rmingon/drone-uwb/base/README.md

## BASE

##### This base use ESP-IDF code for know distance between EACH drone and himself

#### REAL VIEW

REAL VIEW

#### SCHEMATIC VIEW

SCHEMATIC VIEW

#### PCB VIEW

PCB VIEW

#### 3D VIEW

3D VIEW
