rmingon/drone-uwb/drone_2s/README.md

# Drone with 2s battery

### this version use 2s battery for more power in motor with XT30 connector

3d
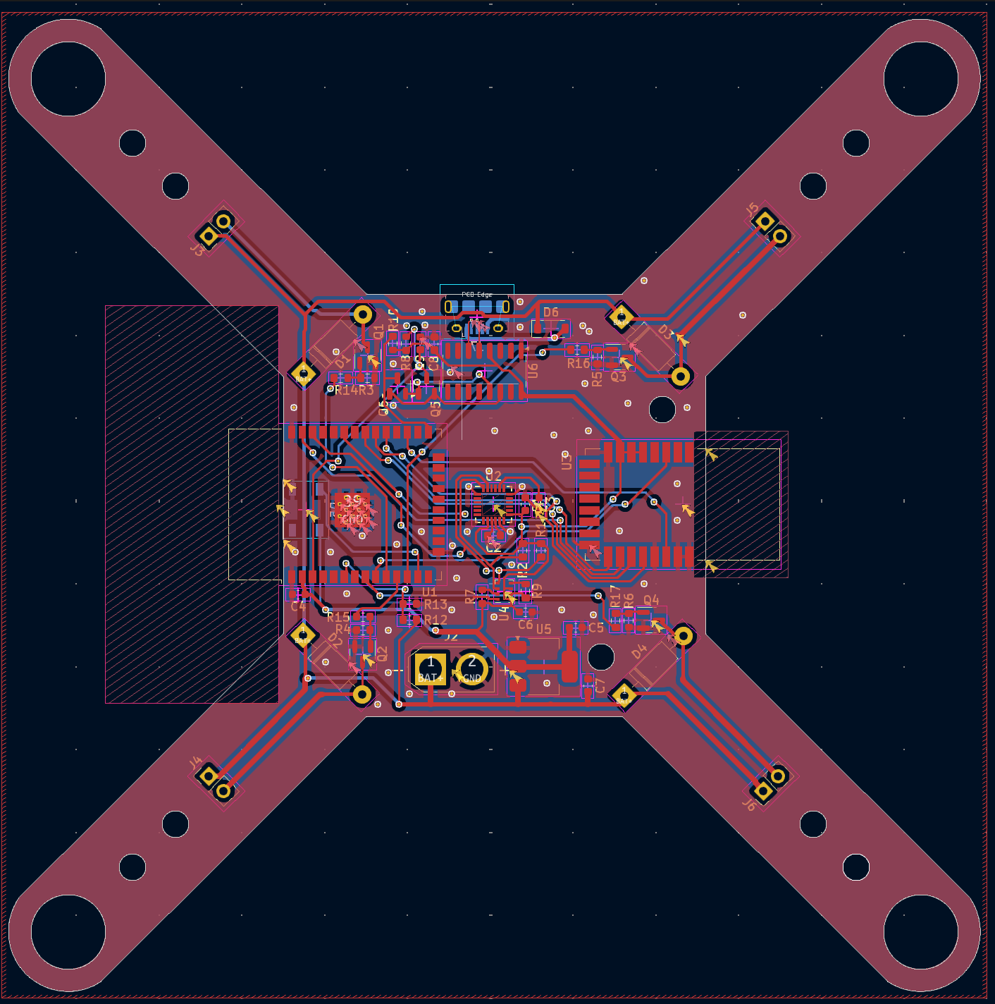
[picture p17: drone_2s/pcb.png]

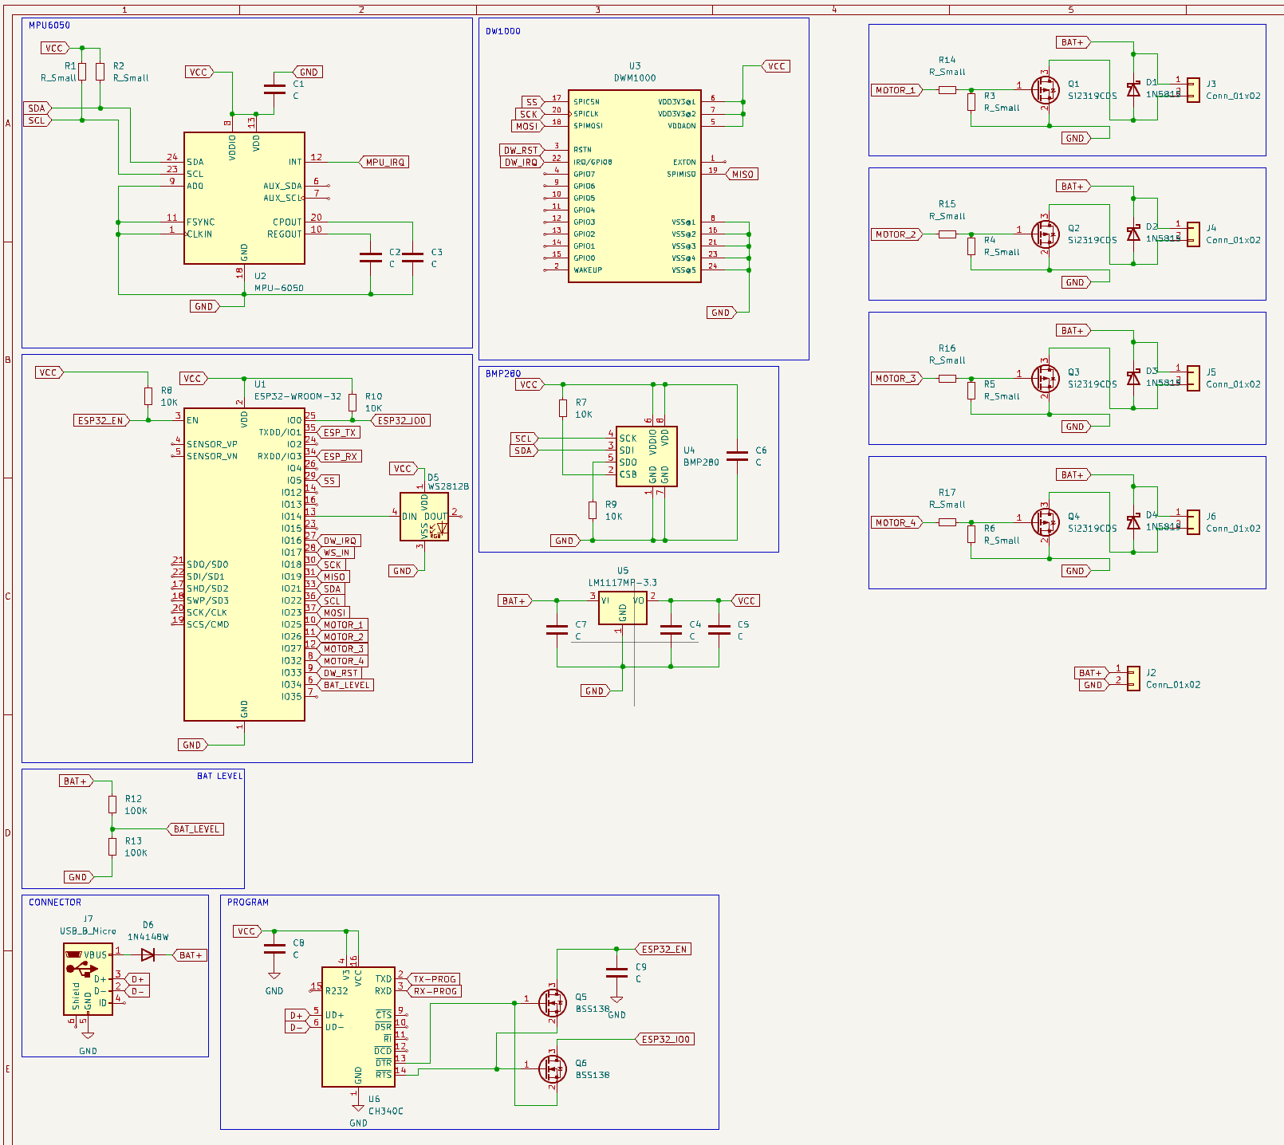
[picture p18: drone_2s/schematic.png]
schematic
