rmingon/drone-uwb/(threads)

Thread 1 (2024-06-29):

Fascinated

jeylites, 2024-06-29:
Hi, seem like a cool project would like to see more development on this. What's the difference between the old and new, beacuse I see the old has a UWB DWM1000 but the new has none but I see two 8 pin header.  How is the localization done for the new, WIFI?

rmingon, 2024-06-29:
Hey @jeylites,
Nice to meet you,
You are right the V2 is an error it's use machine vision and not UWB, I move it to new repository.
The new drone is more like v1.1 than v2, the v1.1 can use external ESC.
The code is the same for v1 and v1.1.
I will shortly add code for bases modules.
