rmingon/drone-uwb/base/code/components/DW1000Ng/include/DW1000NgRTLS.hpp

/*
 * MIT License
 * 
 * Copyright (c) 2018 Michele Biondi, Andrea Salvatori
 * 
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
 * THE SOFTWARE IS PROVIDED "AS IS", WITHOUT WARRANTY OF ANY KIND, EXPRESS OR
 * IMPLIED, INCLUDING BUT NOT LIMITED TO THE WARRANTIES OF MERCHANTABILITY,
 * FITNESS FOR A PARTICULAR PURPOSE AND NONINFRINGEMENT. IN NO EVENT SHALL THE
 * AUTHORS OR COPYRIGHT HOLDERS BE LIABLE FOR ANY CLAIM, DAMAGES OR OTHER
 * LIABILITY, WHETHER IN AN ACTION OF CONTRACT, TORT OR OTHERWISE, ARISING FROM,
 * OUT OF OR IN CONNECTION WITH THE SOFTWARE OR THE USE OR OTHER DEALINGS IN THE
 * SOFTWARE.
*/

#pragma once

#include "DW1000NgPort.hpp"

/* Frame control */
constexpr byte BLINK = 0xC5;
constexpr byte DATA = 0x41;
constexpr byte SHORT_SRC_AND_DEST = 0x88;
constexpr byte LONG_SRC_AND_DEST = 0xCC;
constexpr byte SHORT_SRC_LONG_DEST = 0x8C;
constexpr byte LONG_SRC_SHORT_DEST = 0xC8;

/* Application ID */
constexpr byte RTLS_APP_ID_LOW = 0x9A;
constexpr byte RTLS_APP_ID_HIGH = 0x60;
constexpr uint16_t RTLS_APP_ID = RTLS_APP_ID_LOW | ((uint16_t) (RTLS_APP_ID_HIGH << 8));

/* Function code */
constexpr byte ACTIVITY_CONTROL = 0x10;
constexpr byte RANGING_INITIATION = 0x20;
constexpr byte RANGING_TAG_POLL = 0x21;
constexpr byte RANGING_TAG_FINAL_RESPONSE_EMBEDDED = 0x23;
constexpr byte RANGING_TAG_FINAL_RESPONSE_NO_EMBEDDED = 0x25;
constexpr byte RANGING_TAG_FINAL_SEND_TIME = 0x27;

/* Activity code */
constexpr byte ACTIVITY_FINISHED = 0x00;
constexpr byte RANGING_CONFIRM = 0x01;
constexpr byte RANGING_CONTINUE = 0x02;

/* BLINK Encoding Header */
constexpr byte BATTERY_GOOD = 0x00;
constexpr byte BATTERY_10_30_PERCENT = 0x02;
constexpr byte BATTERY_0_10_PERCENT = 0x01;
constexpr byte NO_BATTERY_STATUS = 0x03;

constexpr byte TEMPERATURE_DATA = 0x20;

constexpr byte EX_ID = 0x80;
constexpr byte NO_EX_ID = 0x40;

/* BLINK Ext Header */
constexpr byte BLINK_RATE_AND_LISTENING = 0x01;
constexpr byte TAG_LISTENING_NOW = 0x02;

enum class NextActivity {
    ACTIVITY_FINISHED,
    RANGING_CONFIRM
};

typedef struct RangeRequestResult {
    boolean success;
    uint16_t target_anchor;
} RangeRequestResult;

typedef struct RangeResult {
    boolean success;
    boolean next;
    uint16_t next_anchor;
    uint32_t new_blink_rate;
} RangeResult;

typedef struct RangeInfrastructureResult {
    boolean success;
    uint16_t new_blink_rate;
} RangeInfrastructureResult;

typedef struct RangeAcceptResult {
    boolean success;
    double range;
    /* Short address of the tag that was ranged. Added to the upstream struct so
       an anchor can tell which tag a measurement belongs to. */
    uint16_t tag_address;
} RangeAcceptResult;

namespace DW1000NgRTLS {
    /*** TWR functions used in ISO/IEC 24730-62:2013, refer to the standard or the decawave manual for details about TWR ***/
    byte increaseSequenceNumber();
    void transmitTwrShortBlink();
    void transmitRangingInitiation(byte tag_eui[], byte tag_short_address[]);
    void transmitPoll(byte anchor_address[]);
    void transmitResponseToPoll(byte tag_short_address[]);
    void transmitFinalMessage(byte anchor_address[], uint16_t reply_delay, uint64_t timePollSent, uint64_t timeResponseToPollReceived);
    void transmitRangingConfirm(byte tag_short_address[], byte next_anchor[]);
    void transmitActivityFinished(byte tag_short_address[], byte blink_rate[]);
    
    boolean receiveFrame();
    void waitForTransmission();
    /*** End of TWR functions ***/
    
    /* Send a request range from tag to the rtls infrastructure */
    RangeRequestResult tagRangeRequest();

    /* Completes an exchange whose poll has already been read off the air, for a
       caller that had to inspect the frame before deciding what to do with it.
       Must be called before any further receive, the poll timestamp is still in
       the register. */
    RangeAcceptResult anchorCompletePoll(byte poll_data[], size_t poll_len, NextActivity next, uint16_t value);

    /* One exchange with one anchor, without walking the rest of the chain.
       Used by an anchor measuring its distance to a peer. */
    RangeResult tagRangeSingle(uint16_t anchor, uint16_t replyDelayUs);

    /* Used by an anchor to accept an incoming tagRangeRequest by means of the infrastructure
       NextActivity is used to indicate the tag what to do next after the ranging process (Activity finished is to return to blink (range request), 
        Continue range is to tell the tag to range a new anchor)
       value is the value relative to the next activity (Activity finished = new blink rante, continue range = new anchor address)
    */
    RangeAcceptResult anchorRangeAccept(NextActivity next, uint16_t value);

    /* Used by tag to range after range request accept of the infrastructure 
       Target anchor is given after a range request success
       Finalmessagedelay is used in the process of TWR, a value of 1500 works on 8mhz-80mhz range devices,
        you could try to decrease it to improve system performance.
    */
    RangeInfrastructureResult tagRangeInfrastructure(uint16_t target_anchor, uint16_t finalMessageDelay);

    /* Can be used as a single function start the localization process from the tag.
        Finalmessagedelay is the same as in function tagRangeInfrastructure
    */
    RangeInfrastructureResult tagTwrLocalize(uint16_t finalMessageDelay);
}
