rmingon/drone-uwb/base/code/src/wifi.c

#include "wifi.h"

#include <string.h>

#include "esp_event.h"
#include "esp_log.h"
#include "esp_mac.h"
#include "esp_netif.h"
#include "esp_wifi.h"
#include "freertos/FreeRTOS.h"
#include "freertos/event_groups.h"
#include "nvs_flash.h"

static const char *TAG = "WIFI";

#define WIFI_CONNECTED_BIT BIT0

static EventGroupHandle_t s_wifi_events;

static void event_handler(void *arg, esp_event_base_t event_base, int32_t event_id, void *event_data)
{
    if (event_base == WIFI_EVENT && event_id == WIFI_EVENT_STA_START) {
        esp_wifi_connect();
    } else if (event_base == WIFI_EVENT && event_id == WIFI_EVENT_STA_DISCONNECTED) {
        xEventGroupClearBits(s_wifi_events, WIFI_CONNECTED_BIT);
        ESP_LOGW(TAG, "disconnected, reconnecting");
        esp_wifi_connect();
    } else if (event_base == IP_EVENT && event_id == IP_EVENT_STA_GOT_IP) {
        const ip_event_got_ip_t *event = (const ip_event_got_ip_t *)event_data;
        ESP_LOGI(TAG, "got ip " IPSTR, IP2STR(&event->ip_info.ip));
        xEventGroupSetBits(s_wifi_events, WIFI_CONNECTED_BIT);
    }
}

esp_err_t wifi_start(const char *ssid, const char *password)
{
    esp_err_t err = nvs_flash_init();
    if (err == ESP_ERR_NVS_NO_FREE_PAGES || err == ESP_ERR_NVS_NEW_VERSION_FOUND) {
        ESP_ERROR_CHECK(nvs_flash_erase());
        err = nvs_flash_init();
    }
    ESP_ERROR_CHECK(err);

    s_wifi_events = xEventGroupCreate();
    if (s_wifi_events == NULL) {
        return ESP_ERR_NO_MEM;
    }

    ESP_ERROR_CHECK(esp_netif_init());
    ESP_ERROR_CHECK(esp_event_loop_create_default());
    esp_netif_create_default_wifi_sta();

    wifi_init_config_t init_config = WIFI_INIT_CONFIG_DEFAULT();
    ESP_ERROR_CHECK(esp_wifi_init(&init_config));

    ESP_ERROR_CHECK(esp_event_handler_instance_register(WIFI_EVENT, ESP_EVENT_ANY_ID, &event_handler, NULL, NULL));
    ESP_ERROR_CHECK(esp_event_handler_instance_register(IP_EVENT, IP_EVENT_STA_GOT_IP, &event_handler, NULL, NULL));

    wifi_config_t wifi_config = {0};
    strlcpy((char *)wifi_config.sta.ssid, ssid, sizeof(wifi_config.sta.ssid));
    strlcpy((char *)wifi_config.sta.password, password, sizeof(wifi_config.sta.password));

    ESP_ERROR_CHECK(esp_wifi_set_mode(WIFI_MODE_STA));
    ESP_ERROR_CHECK(esp_wifi_set_config(WIFI_IF_STA, &wifi_config));
    ESP_ERROR_CHECK(esp_wifi_start());

    ESP_LOGI(TAG, "connecting to \"%s\"", ssid);
    return ESP_OK;
}

bool wifi_wait_connected(uint32_t timeout_ms)
{
    const EventBits_t bits = xEventGroupWaitBits(s_wifi_events, WIFI_CONNECTED_BIT, pdFALSE, pdFALSE,
                                                 pdMS_TO_TICKS(timeout_ms));
    return (bits & WIFI_CONNECTED_BIT) != 0;
}

esp_err_t wifi_get_mac(uint8_t mac[6])
{
    return esp_read_mac(mac, ESP_MAC_WIFI_STA);
}
