rmingon/drone-uwb/esp-idf/main/led.c

/*
 * led.c
 *
 *  Created on: Sep 26, 2023
 *      Author: roro
 */

#include "led_strip.h"
#include "led.h"
#include "esp_log.h"
#include "esp_err.h"

// GPIO assignment
#define LED_STRIP_BLINK_GPIO  14
// Numbers of the LED in the strip
#define LED_STRIP_LED_NUMBERS 1
// 10MHz resolution, 1 tick = 0.1us (led strip needs a high resolution)
#define LED_STRIP_RMT_RES_HZ  (10 * 1000 * 1000)

static const char *TAG = "LED";

led_strip_handle_t led_strip;

led_strip_handle_t ledInit(void)
{
    // LED strip general initialization, according to your led board design
    led_strip_config_t strip_config = {
        .strip_gpio_num = LED_STRIP_BLINK_GPIO,   // The GPIO that connected to the LED strip's data line
        .max_leds = LED_STRIP_LED_NUMBERS,        // The number of LEDs in the strip,
        .led_pixel_format = LED_PIXEL_FORMAT_GRB, // Pixel format of your LED strip
        .led_model = LED_MODEL_WS2812,            // LED strip model
        .flags.invert_out = false,                // whether to invert the output signal
    };

    // LED strip backend configuration: RMT
    led_strip_rmt_config_t rmt_config = {
        .clk_src = RMT_CLK_SRC_DEFAULT,        // different clock source can lead to different power consumption
        .resolution_hz = LED_STRIP_RMT_RES_HZ, // RMT counter clock frequency
        .flags.with_dma = false,               // DMA feature is available on ESP target like ESP32-S3
    };

    // LED Strip object handle
    led_strip_handle_t led_strip;
    ESP_ERROR_CHECK(led_strip_new_rmt_device(&strip_config, &rmt_config, &led_strip));
    return led_strip;
}

void setLed(Color color)
{
	ESP_ERROR_CHECK(led_strip_set_pixel(led_strip, 0, color.r, color.g, color.b));
	led_strip_refresh(led_strip);
}
