rmingon/drone-uwb/(commit log)

2023-02-12 add esp32 + mpu6050 + DWM1000
    [drone.kicad_pcb, drone.kicad_sch]
2023-02-12 up pcb
    [drone.kicad_pcb, drone.kicad_sch]
2023-02-12 add reamde
    [drone.kicad_pcb]
2023-02-12 up readme
    [drone.kicad_pcb]
2023-02-12 add kicad base pcb
    [base.kicad_pcb, base.kicad_sch]
2023-02-13 add base pcb
    [base.kicad_pcb, base.kicad_sch]
2023-02-13 update gitignore
    [base.kicad_pcb]
2023-02-13 add BMP280 for altimeter sensor
    [base.kicad_pcb, base.kicad_sch]
2023-02-14 add drone BMP280
    [base.kicad_pcb, drone.kicad_pcb, drone.kicad_sch]
2023-03-07 add pcb gitignore
2023-03-12 update drone 3D pcb
2023-03-12 update pcb m328p to esp32
    [drone.kicad_pcb, drone.kicad_sch]
2023-03-12 update drone pcb view
2023-03-12 update drone schematic_pcb.png
2023-03-13 update hole
    [drone.kicad_pcb]
2023-03-25 drone esp32
2023-03-26 add motor class
2023-03-26 motor pin
2023-03-26 class motor
2023-03-26 add motor logic
2023-03-27 bmp remove pressure and temp
2023-03-27 add more pwm
2023-03-27 change pwm frequency
2023-03-27 change uart bauds
2023-03-27 add min motor speed + altimeter automatic position
2023-03-27 add tps63001
    [drone.kicad_pcb, drone.kicad_sch]
2023-03-27 wiring tps63001
    [drone.kicad_pcb, drone.kicad_sch]
2023-03-27 add ws2812b + wiring
    [drone.kicad_pcb, drone.kicad_sch]
2023-03-27 add bat level wiring
    [drone.kicad_pcb, drone.kicad_sch]
2023-03-28 more wire
    [drone.kicad_pcb]
2023-03-28 change rst dw1000 pin
    [base.kicad_pcb, base.kicad_sch]
2023-04-02 add resistor current limitator
    [drone.kicad_pcb, drone.kicad_sch]
2023-04-19 add test motor method
2023-04-20 change battery voltage sensor to adc1
    [drone.kicad_sch]
2023-04-20 add test motor at boot
2023-04-29 add set offset motor
2023-05-03 update adc bat level pin
    [drone.kicad_pcb]
2023-05-05 add tps63001 on base
    [base.kicad_sch]
2023-05-05 add mcp73831 on base
    [base.kicad_sch]
2023-05-05 add battery system with charge
    [base.kicad_pcb]
2023-05-05 battery wiring
2023-05-19 base with battery
    [base.kicad_pcb]
2023-05-19 send to jlcpcb
    [base.kicad_pcb]
2023-07-04 fix battery charging
    [base.kicad_pcb, base.kicad_sch]
2023-07-24 thanks to pcbWAY
2023-08-14 add pcbway sponsor
2023-08-14 change diode footprint
    [base.kicad_pcb, base.kicad_sch]
2023-09-22 first commit with ws2812 led support
2023-09-25 add motor define pin
2023-09-25 add pwm init
2023-09-25 add motor begin value
2023-09-25 add motor set pwm pinout
2023-09-26 add led file
2023-09-26 add motor file
2023-09-26 fix led color
2023-09-26 motor fix
2023-09-26 add i2c file
2023-09-27 change i2c to last api
2023-10-16 add new drone schematic
    [drone.kicad_pcb, drone.kicad_sch]
2023-10-16 add pcb cut
    [drone.kicad_pcb]
2023-10-16 first wiring
    [drone.kicad_pcb, drone.kicad_sch]
2023-10-17 add all ESC
    [drone.kicad_sch]
2023-10-17 add regulator
    [drone.kicad_pcb, drone.kicad_sch]
2023-10-17 add regulator + xt60 connector
    [drone.kicad_pcb, drone.kicad_sch]
2023-10-17 add openmv cam pin
    [drone.kicad_pcb, drone.kicad_sch]
2023-10-17 text on new drone
    [drone.kicad_pcb]
2023-10-18 mpu6050 to 9250
    [drone.kicad_pcb, drone.kicad_sch]
2023-10-26 update wiring
    [drone.kicad_pcb]
2023-11-14 change hole size
    [drone.kicad_pcb]
2024-06-11 add new drone v2.1
    [drone.kicad_sch, pcb.kicad_pcb, pcb.kicad_sch]
2024-06-11 add components
    [pcb.kicad_sch]
2024-06-12 add A5936 esc
    [pcb.kicad_sch]
2024-06-13 add motor esc
    [pcb.kicad_sch]
2024-06-13 add regulator + add bmp230
    [pcb.kicad_sch]
2024-06-18 move base project
    [base.kicad_pcb, base.kicad_sch]
2024-06-18 add base finish
    [base.kicad_pcb, base.kicad_sch]
2024-06-18 add drone without esc
    [drone.kicad_pcb, drone.kicad_sch, pcb.kicad_pcb, pcb.kicad_sch]
2024-06-18 update new drone format
    [drone.kicad_pcb, drone.kicad_sch]
2024-06-19 chnage output directory
    [drone.kicad_pcb]
2024-06-29 add drone esc view
2024-06-29 move project
    [drone.kicad_pcb, drone.kicad_sch]
2024-06-29 add drone with esc
2024-07-07 add esc init
2024-07-12 up pwm esc
2024-07-13 update arm esc
2024-07-13 add arm method
2024-07-13 add motor method
2024-07-15 update led + remove unused
2024-07-24 edit esc arm + conifg
2024-08-06 add 2s version
    [drone.kicad_pcb, drone.kicad_sch]
2024-08-09 add servo lib
2024-08-14 upgarde version
    [drone.kicad_sch]
2024-08-14 upgrade motor pin
2024-08-14 pid upgrade + ws
2025-01-12 move via pad
    [drone.kicad_pcb]
2025-01-26 motors mounted on pcb + usb program
    [drone.kicad_pcb, drone.kicad_sch]
2025-01-27 fix via size
    [drone.kicad_pcb]
2025-02-05 fix drone uart wiring
    [drone.kicad_pcb, drone.kicad_sch]
2026-09-17 base: vendor the DW1000Ng driver as an ESP-IDF component
    The anchor firmware pulled f-army/DW1000-ng from the PlatformIO registry,
    which only exists for the Arduino core. Vendor it and port the platform
    layer so it can be built by ESP-IDF; the register logic is untouched.
    - SPIporting runs on spi_master with a manual chip select and a DMA
    bounce buffer, since the driver hands it plain stack arrays
    - DW1000NgPort.hpp replaces <Arduino.h>. delay() busy-waits below one
    tick because vTaskDelay() rounds delay(1) down to zero at the default
    100 Hz, and the DW1000 start-up sequence needs those waits to happen
    - attachInterrupt() dispatches from a task rather than an ISR, the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
    [DW1000Ng.cpp, DW1000Ng.hpp, DW1000NgConfiguration.hpp, DW1000NgConstants.hpp, DW1000NgPort.cpp, DW1000NgPort.hpp, DW1000NgRTLS.cpp, DW1000NgRTLS.hpp]
2026-09-17 base: move the anchor firmware from Arduino to ESP-IDF
    Switches framework to espidf and replaces the four Arduino libraries
    rather than shimming them:
    LiteLED -> src/led.c, WS2812 over the RMT encoder
    ArduinoJson -> espressif/cjson, which left ESP-IDF core in v6
    WiFi/WiFiUDP -> esp_wifi plus lwip BSD sockets
    Serial.print -> ESP_LOG*
    UDP_PORT was never defined, so the project could not have compiled as
    committed. It is 7051, read off code/server/src/index.ts, which binds
    that port and replies to the anchor on it.
    uniq is still built with %x per MAC byte, leading zeros dropped, so
    anchors keep the identity the server already knows.
    COMPILER_DISABLE_DEFAULT_ERRORS is needed be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
    [config.h, led.c, led.h, main.cpp, wifi.c, wifi.h]
2026-09-17 base: measure distance by time of flight instead of signal strength
    The anchor broadcast its id and reported getReceiveQuality() as if it
    were a distance. That is RSSI in disguise: metres of error, and very
    sensitive to orientation and obstacles. Use the two way ranging the
    DW1000 is built for, which lands around 10 cm once calibrated.
    Anchors form a chain. A tag blinks at the main anchor, which hands it a
    short address, then each anchor ranges in turn and passes the tag to its
    successor; the last one sends it back to blinking. Roles are set per
    board in config.h. Every anchor reports its own distance, so the server
    gets one measurement per anchor per cycle.
    What goes on top of the raw exc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
    [config.h, main.cpp, ranging.cpp, ranging.h, uwb_profile.h]
2026-09-17 drone: take part in the two way ranging exchange
    The DW1000 block had been commented out, so the tag side was dormant and
    the anchors had nothing to range against.
    It runs as a task pinned to core 0: the ranging exchange busy-waits while
    it holds the radio, and the PID loop on core 1 must not pay for that.
    The tag EUI is derived from the wifi MAC and sent to the server when the
    drone connects, which is what ties an anchor's measurement back to this
    drone. uwb_profile.h is the same file as the anchors'.
    src/config.h did not exist, so the project could not build at all. Added
    with the symbols main.cpp needs; THROTTLE_* are 0 and 255 because Motor
    takes a uint8_t.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
2026-09-17 docs: describe the UWB positioning system
    The root README covered the boards but never said how the drone is meant
    to know where it is. Adds the ranging chain, what makes a measurement
    trustworthy, the two radio profiles and their trade off, the calibration
    procedure, the UDP protocol and a quick start per component. Board photos
    move into collapsed sections so the page stays readable.
    Status is stated plainly: the firmware builds but has not flown, and
    trilateration is not implemented because anchor coordinates are not
    configured anywhere yet.
    base/code gets its own README for the anchor specifics.
2026-09-17 base: let the anchors measure each other
    An anchor only ever ranged tags, so nothing knew the shape of the
    installation and the anchor coordinates a position fix needs had to be
    measured by hand. Between tag cycles each anchor now plays tag towards
    its peers, which fills in the distance matrix of the network itself.
    The peer computes and reports the leg, as it does for a tag, so a board
    lists every peer it wants a distance to. Short addresses below
    RANGING_FIRST_TAG_ADDRESS belong to anchors, which is how the peer tells
    the two apart and files the measurement as "peer" rather than "range".
    Two additions to the vendored driver:
    - tagRangeSingle(), the existing tagFinishRange() made publi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
    [DW1000NgRTLS.cpp, DW1000NgRTLS.hpp, config.h, main.cpp, ranging.cpp, ranging.h]
2026-09-17 server: turn the survey into coordinates and serve them live
    The anchors now report the distances between themselves, which is enough
    to place them. solveLayout() puts the first anchor at the origin, the
    second on the X axis and trilaterates the rest. Distances cannot tell a
    layout from its mirror image, so that frame is a convention rather than a
    measurement, and it is stated as one.
    solvePosition() then places a drone from its distances by least squares,
    working in the plane the anchors define rather than the world XY plane so
    that a tilted or wall mounted set behaves like a floor mounted one. Three
    anchors leave two mirrored solutions, so an obstructed distance is used
    rather than droppe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
2026-09-17 front: 3D view of the anchor network
    The app imported a store that did not exist, so it did not build. It is
    now a live view of the installation: anchors where the survey puts them,
    a labelled link for every measured distance, and the drones on top, with
    a panel listing the same numbers.
    TresJS needs its plugin registered and its template compiler options, or
    every Tres tag fails to resolve and Vue never mounts.
    Distance labels are canvas sprites rather than real text: no font file to
    ship, and they always face the camera. They are cached per link and
    repainted in place, since rebuilding them four times a second would churn
    GPU memory for nothing.
    ?demo=1 feeds the view a generated instal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
2026-09-17 base: track the component lock instead of ignoring it
    dependencies.lock pins the exact component versions the build resolves,
    cJSON 1.7.19~2 here, so tracking it makes the resolution reproducible.
    esp-idf/dependencies.lock is already tracked, so this also makes the two
    ESP-IDF projects consistent.
    managed_components stays ignored: 1.9 MB of vendored sources the lock is
    enough to fetch again.
2026-09-17 chore: ignore macOS and KiCad leftovers
    .DS_Store appears in every directory browsed in Finder, and KiCad 7 drops
    a <project>-backups folder next to the board as soon as it is edited.
    Neither was covered.
